Antonio-systemm/HydroTower/README.md

# HydroTower
# il tutorial va fatto in ordine :
# 1. configurazione arduino e cavi raspberry
# 2. configurazione raspberry
# 3. configurazione app
