Antonio-systemm/HydroTower/Documentazione/Componenti Utilizzati.docx

# Spiegazione teorica del progetto

Componenti:

server:
raspberry pi 4 model b 8gb di ram

sistema operativo:

linux(raspberry pi OS lite)

memoria:

micro sd da 64 gb

database:

SQLITE

Web server:

nginx

lettore segnali analogici:

arduino nano (collegato via usb al raspberry pi 4)

sensori usati:
sensore umidità aria e temperatura ambiente (https://amzn.eu/d/0a2MOeiQ)

sensore di umidità del terreno (https://www.amazon.it/dp/B07CQT5RC8?ref=ppx_pop_mob_ap_share)

sensore luce (https://www.amazon.it/dp/B083KM51DF?ref=ppx_pop_mob_ap_share)

sensore TDS (https://www.amazon.it/dp/B0DM8NB945?ref=ppx_pop_mob_ap_share)

sensore PH (https://www.amazon.it/dp/B0GZV8PHYM?ref=ppx_pop_mob_ap_share)https://www.amazon.it/dp/B0GZV8PHYM?ref=ppx_pop_mob_ap_share)

sensor di presenza dell’acqua (https://amzn.eu/d/07mXANo3)

DIspositivi controllo:
relè 5V (https://amzn.eu/d/0hM7x1w9)

backend:

gestito con file python

Servizio per invio notifiche al cellulare:

Firebase

Software per la creazione dell’app android:

android studio con flutter

Api intelligenze artificiali:

Gemini e groq

Raspberry pi 4 model B da 8gb di ram contiene tutti i file e esegue: i calcoli, le richieste alla pagina web, le richieste al backend, la gestione dei dati nel database di prelevare/aggiungere/modificare/rimuovere dati con dentro una micro sd da 64 gb, al pin del raspberry collegheremo il sensore di umidità del aria e della temperatura ambiente e collegheremo via usb un arduino nano che invia al raspberry i segnali tradotti degli altri sensori analogici in fine collegheremo via usb una webcam che punta sulle piante per inviare l’immagine alle intelligenze artificiali via API.

Quello che dovrà fare è raccogliere i dati fare una foto mandare tutto a gemini ricevere una analisi che ti imposta in automatico i valori consigliati e in caso di violazione di questi valori arriva un notifica.

Il sistema deve essere in grado di gestire il flusso dell’acqua in autonomo e quando la pianta è pronta per essere raccolta deve inviare un messaggio all’utente.

Questo sistema funziona con un’app che si collega tramite indirizzo ip, su quest’app puoi regolare le impostazioni di avviso manualmente e vedere e gestire tutti i report salvati.

L’app è anche stata semplificata e resa facilmente accessibile per tutti grazie a una interfaccia semplificata e l’integrazione di comandi vocali e sintetizzatore vocale e la aggiunta di comandi rapidi vocali.

Per gestire le notifiche si è usato firebase che permette di ricevere notifiche anche quando non si ricevono informazioni direttamente dal raspberry.

Per la creazione delle app si è usato android studio con modello flutter.
