Antonio-systemm/HydroTower/file stampa 3d/file stampa 3d/720081-modular-hydroponic-tower-c084b1f4-a7fd-4b44-bbda-dc36e77a3913.pdf

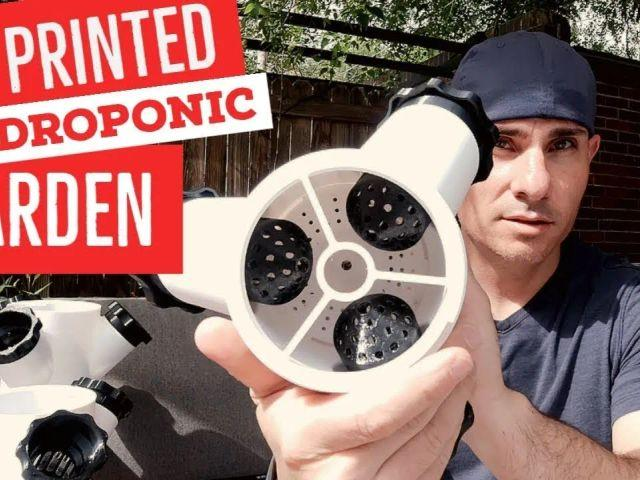
[picture p23: figure]

28.73 hrs

4 pcs

f

0.30 mm

k

0.40 mm

h

PET

553 g

d

Prusa

MK3S/S+ &

MMU2S/3

## Summary

This is a remix of one of the original modular hydroponic towers.

Household (https://printables.com/model?categoryId=3) > Outdoor & Garden (https://printables.com/model?categoryId=53)

Tags: hydroponic

Complete list of parts and 3d models used to create your own Hydroponic Tower:

https://kit.co/AllYourTech/3d-printed-hydroponic-tower-suggested-parts

Today i'm putting together a 3d printed modular hydroponic tower garden. It's an exciting print, and just in time to get your backyard garden ready for summer. Below you will find all of the parts used so you can get started building your own.

The lid uses 18 M3x6 bolts and nuts to fasten everything together.

blove (https://printables.com/@blove_45981)

## Modular

## Hydroponic Tower

VIEW IN BROWSER (https://printables.com/model/720081-modular-hydroponic-tower)

updated 13. 1. 2024 | published 13. 1. 2024

## Model files

General Hydroponics Maxigro and Maxibloom Fertilizer: https://geni.us/BI1hrD (https://geni.us/BI1hrD)

VIVOSUN pH and TDS Meter Combo: https://geni.us/ZB8V

General Hydroponics pH Control Kit: https://geni.us/0N8XhRP

Rockwool Grow Cubes: https://geni.us/bKYaVm

3000 Pre-Fed Live Ladybugs: https://geni.us/8u8z

Infinite repeat cycle timer plug: https://geni.us/oAtH

VIVOSUN 800GPH Submersible Pump: https://geni.us/y8krA

3/8" ID 1/2" OD Clear Vinyl Tubing-25 Ft: https://geni.us/VgmElP

5 gallon bucket: https://geni.us/UIAAhJl

OVERTURE PETG Filament: https://geni.us/g1sC

One Month Update:

maintenance:

## This remix is based on

Modular Hydroponics Tower: Ebb & Flow

by Beadsworth (https://www.thingiverse.com/thing:3863771)

lid_no_holes_custom.stl

standard_pot_for_4-5-way_planting_module_customized.stl

3-way_planting_module_custom.stl

jiffy-7_41_pot_custom.stl

standard_pot_customized.stl

module_adapter_custom.stl

dispenser_module_custom.stl

4-way_planting_module_customizedstl.stl

hydro_tower_-_water_cap_for_bucket.stl

hydro_tower_-_bucket_adapter.stl

stream_breaker.stl

module_spacer_120mm.stl

## Print files

h PET | k 0.40 mm | f 0.30 mm | 4.59 hrs | 91 g

d Prusa MK3S/S+ & MMU2S/3

h PET | k 0.40 mm | f 0.30 mm | 7.40 hrs | 153 g

d Prusa MK3S/S+ & MMU2S/3

h PET | k 0.40 mm | f 0.30 mm | 5.35 hrs | 100 g | d Prusa MK3S/S+ & MMU2S/3
h PET | k 0.40 mm | f 0.30 mm | 11.39 hrs | 209 g | d Prusa MK3S/S+ & MMU2S/3

## License

This work is licensed under a
Creative Commons (4.0 International License)

Attribution-NonCommercial (http://creativecommons.org/licenses/by-nc/4.0/)

module_spacer_40mm.stl

module_spacer_80mm.stl

lid_without_holes-1_03mm_petg_mk3smmu2s_4h36m.gcode

module_spacer_120mm_03mm_petg_mk3smmu2s_7h24m.gcode

dispenser_module_internal_03mm_petg_mk3smmu2s_5h21m.gcode

3-way_planting_module_hollow_03mm_petg_mk3smmu2s_11… .gcode

✖ | Sharing without ATTRIBUTION
✔ | Remix Culture allowed
✖ | Commercial Use
✖ | Free Cultural Works
✖ | Meets Open Definition
