Antonio-systemm/HydroTower/file stampa 3d/file stampa 3d/4-way_planting_module_customizedstl.stl

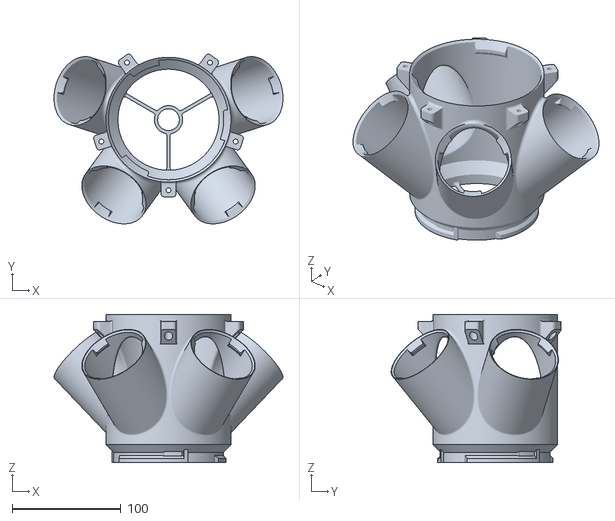
[picture p24: CAD file, 2026-09-21]
file stampa 3d/file stampa 3d/4-way_planting_module_customizedstl.stl
210.8 x 156.2 x 136.5
