Antonio-systemm/HydroTower/file stampa 3d/file stampa 3d/module_spacer_80mm.stl

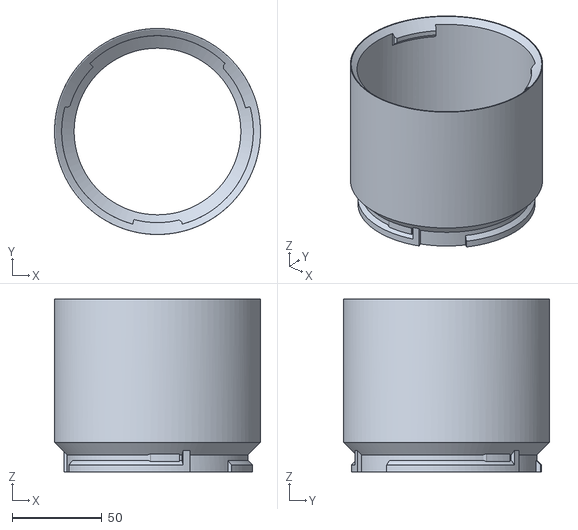
[picture p25: CAD file, 2026-09-21]
file stampa 3d/file stampa 3d/module_spacer_80mm.stl
115.0 x 115.0 x 96.5
