Antonio-systemm/HydroTower/file stampa 3d/file stampa 3d/stream_breaker.stl

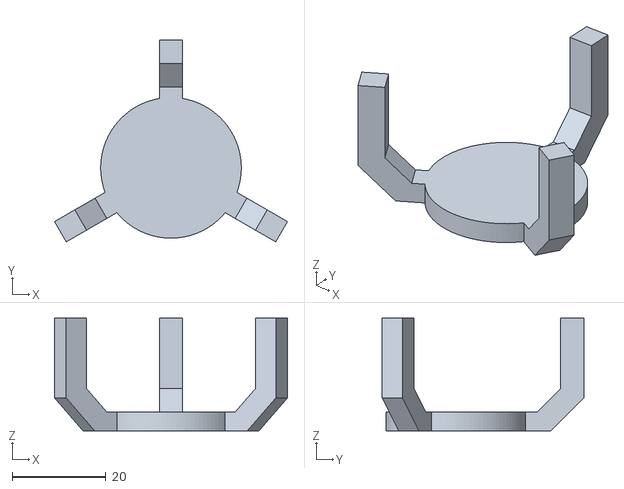
[picture p27: CAD file, 2026-09-21]
file stampa 3d/file stampa 3d/stream_breaker.stl
49.7 x 43.0 x 24.0
