Antonio-systemm/HydroTower/file stampa 3d/file stampa 3d/3-way_planting_module_custom.stl

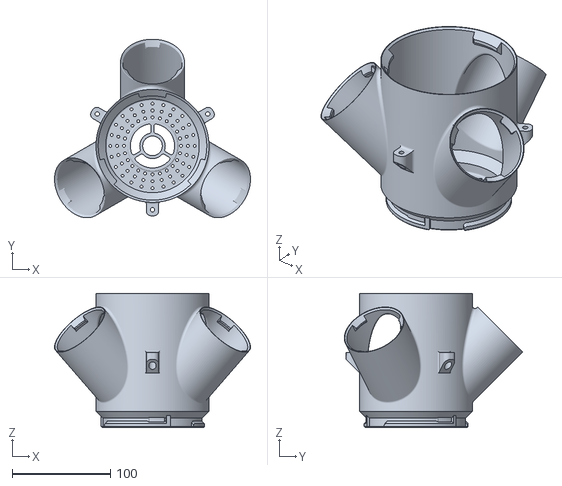
[picture p28: CAD file, 2026-09-21]
file stampa 3d/file stampa 3d/3-way_planting_module_custom.stl
199.6 x 181.7 x 136.5
