Antonio-systemm/HydroTower/file stampa 3d/file stampa 3d/module_adapter_custom.stl

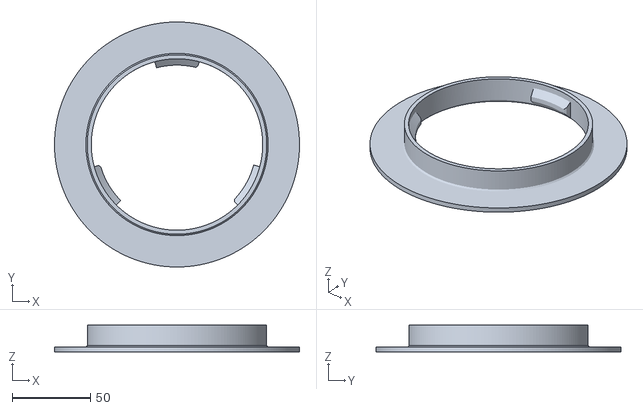
[picture p29: CAD file, 2026-09-21]
file stampa 3d/file stampa 3d/module_adapter_custom.stl
157.0 x 157.0 x 17.0
