Antonio-systemm/HydroTower/file stampa 3d/file stampa 3d/jiffy-7_41_pot_custom.stl

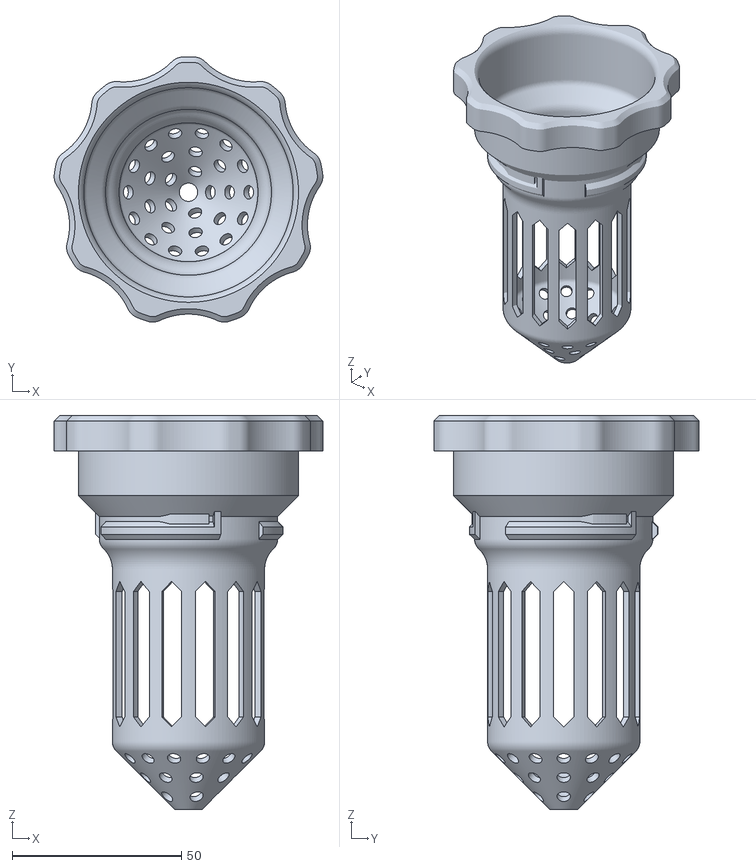
[picture p30: CAD file, 2026-09-21]
file stampa 3d/file stampa 3d/jiffy-7_41_pot_custom.stl
79.4 x 78.4 x 116.4
