Antonio-systemm/HydroTower/file stampa 3d/file stampa 3d/module_spacer_120mm.stl

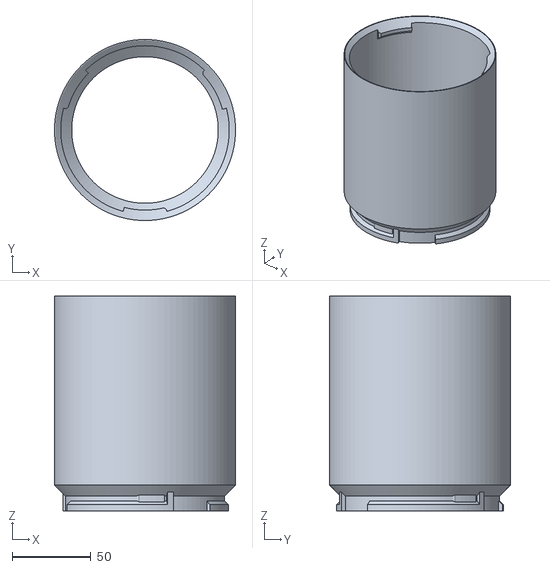
[picture p31: CAD file, 2026-09-21]
file stampa 3d/file stampa 3d/module_spacer_120mm.stl
114.9 x 115.0 x 136.5
