Antonio-systemm/HydroTower/file stampa 3d/file stampa 3d/hydro_tower_-_water_cap_for_bucket.stl

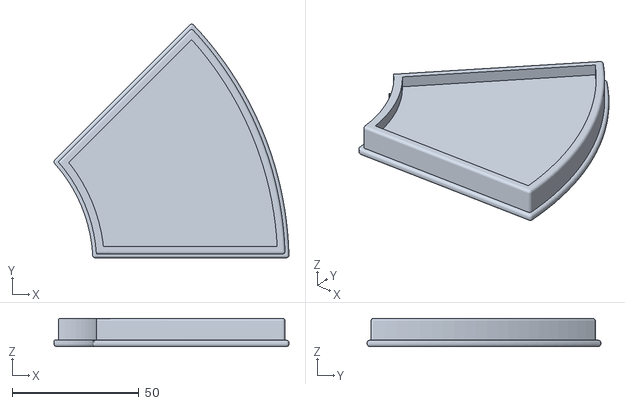
[picture p32: CAD file, 2026-09-21]
file stampa 3d/file stampa 3d/hydro_tower_-_water_cap_for_bucket.stl
92.5 x 92.0 x 11.1
