Antonio-systemm/HydroTower/file stampa 3d/file stampa 3d/dispenser_module_custom.stl

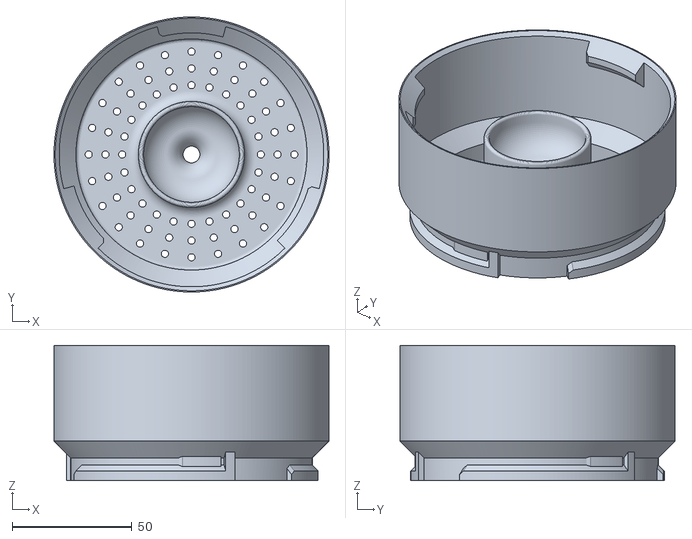
[picture p33: CAD file, 2026-09-21]
file stampa 3d/file stampa 3d/dispenser_module_custom.stl
115.0 x 115.0 x 56.5
