Antonio-systemm/HydroTower/file stampa 3d/file stampa 3d/lid_no_holes_custom.stl

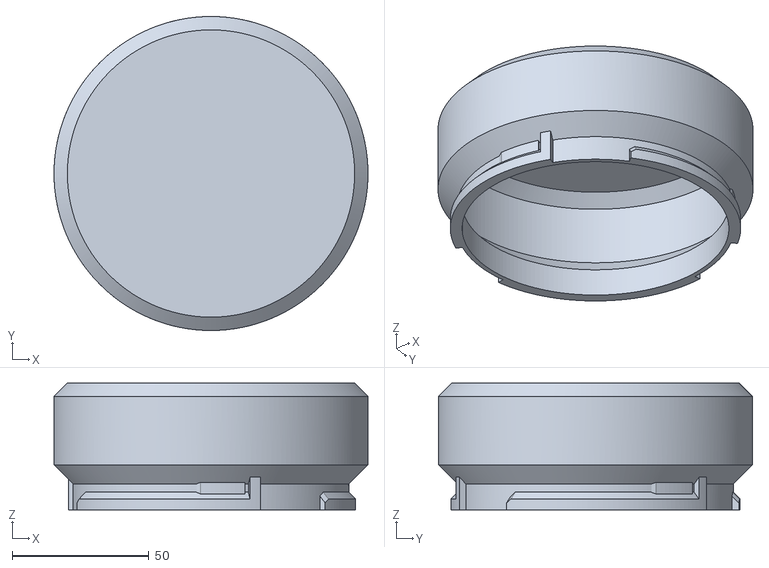
[picture p34: CAD file, 2026-09-21]
file stampa 3d/file stampa 3d/lid_no_holes_custom.stl
115.0 x 115.0 x 46.5
