Antonio-systemm/HydroTower/file stampa 3d/file stampa 3d/standard_pot_for_4-5-way_planting_module_customized.stl

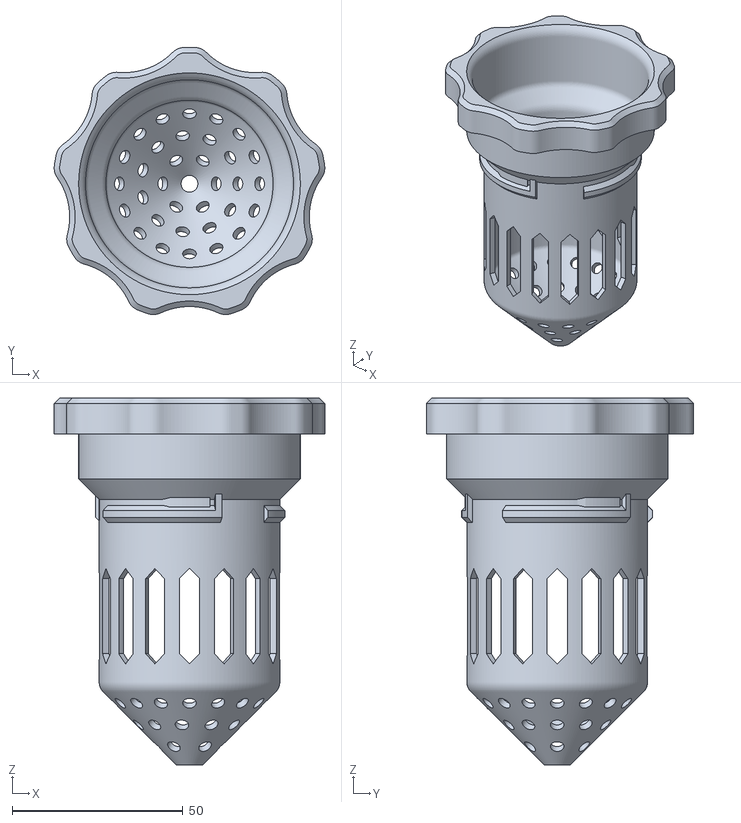
[picture p35: CAD file, 2026-09-21]
file stampa 3d/file stampa 3d/standard_pot_for_4-5-way_planting_module_customized.stl
79.4 x 78.4 x 107.6
