Antonio-systemm/HydroTower/file stampa 3d/file stampa 3d/hydro_tower_-_bucket_adapter.stl

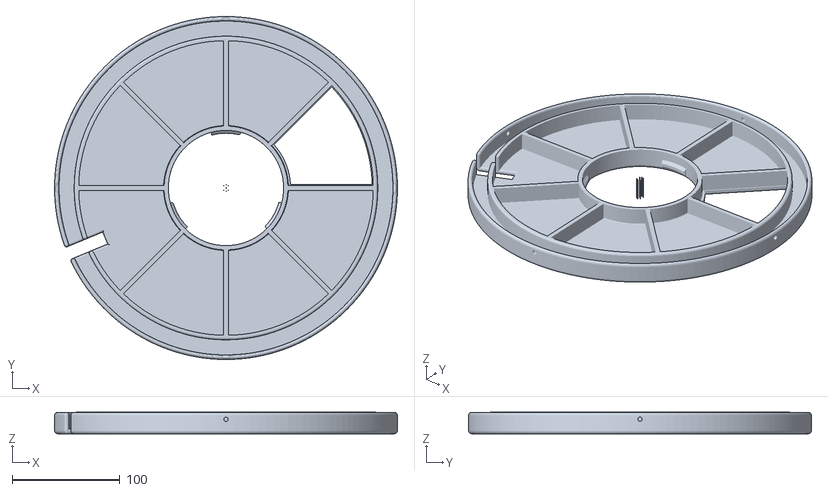
[picture p36: CAD file, 2026-09-21]
file stampa 3d/file stampa 3d/hydro_tower_-_bucket_adapter.stl
318.5 x 318.5 x 20.0
