Antonio-systemm/HydroTower/file stampa 3d/file stampa 3d/standard_pot_customized.stl

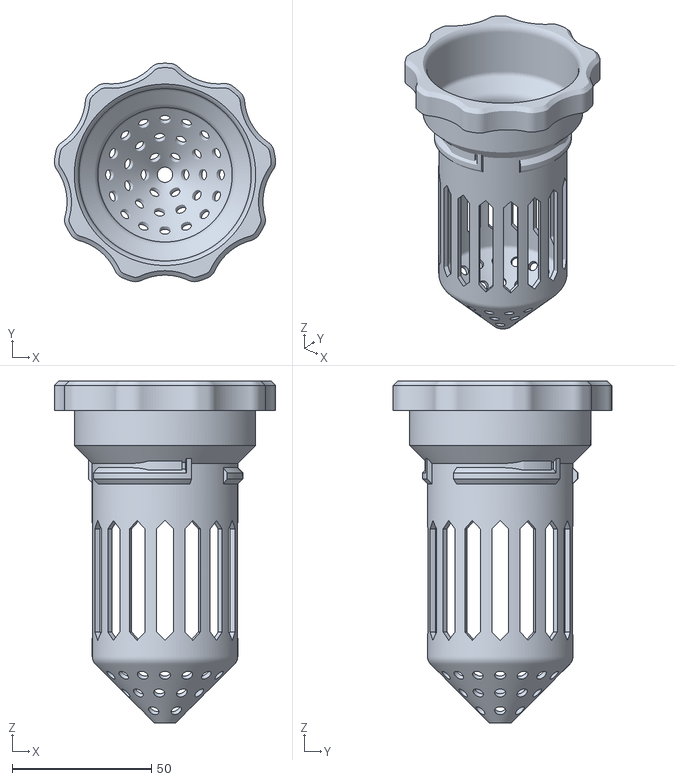
[picture p37: CAD file, 2026-09-21]
file stampa 3d/file stampa 3d/standard_pot_customized.stl
79.4 x 78.4 x 122.6
